pollen-robotics/dxl-fan-module/dxl-fan-module/schematic.pdf

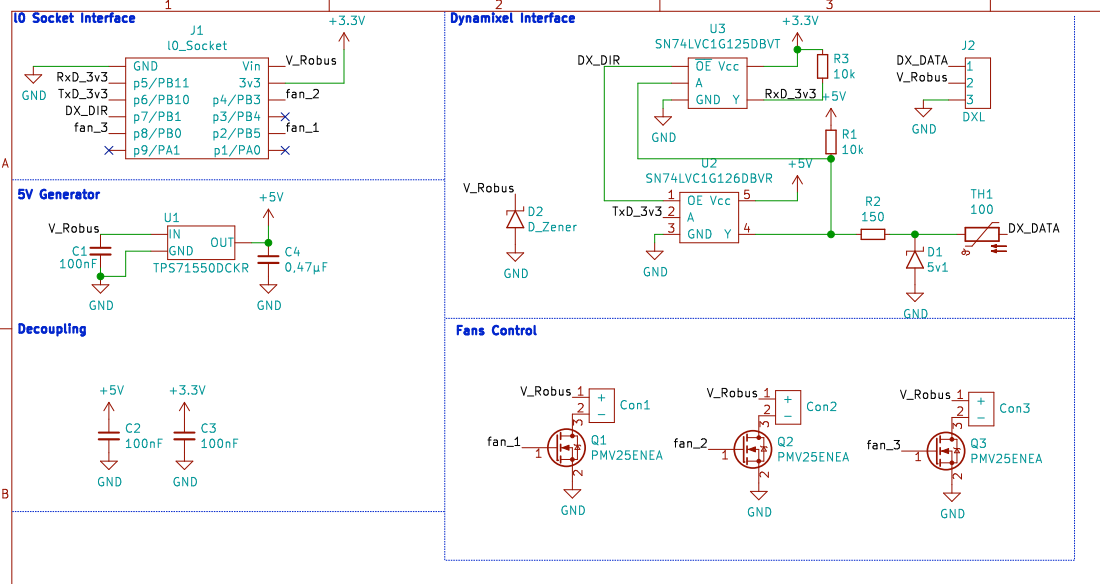
[picture p2: page 1]
