pollen-robotics/dxl-fan-module/(commit log)

2020-04-07 Add KiCad project
    [l0_Dynamixel.kicad_pcb, l0_Dynamixel.sch]
2020-04-07 Move files to a folder
    [l0_Dynamixel.kicad_pcb, l0_Dynamixel.sch]
2020-04-07 Add connectors for fans, logos and improve route tracks
    [l0_Dynamixel.kicad_pcb, l0_Dynamixel.sch]
2020-04-08 Change connectors
    [l0_Dynamixel.kicad_pcb, l0_Dynamixel.sch]
2020-04-08 Fix D_Zener and silkscreen/fab layers
    [l0_Dynamixel.kicad_pcb, l0_Dynamixel.sch]
2020-04-08 Change 1k resistors into 0ohm
    [l0_Dynamixel.kicad_pcb, l0_Dynamixel.sch]
2020-04-08 Change filled zones
    [l0_Dynamixel.kicad_pcb]
2020-04-08 Remove useless vias
    [l0_Dynamixel.kicad_pcb]
2020-04-08 Rename files
    [dxl-fan-module.kicad_pcb, dxl-fan-module.sch]
2020-04-09 Remove 0ohm resistors
    [dxl-fan-module.kicad_pcb, dxl-fan-module.sch]
2020-04-09 Change farnell code for R1 and R3
    [dxl-fan-module.sch]
2020-05-05 Add files needed for production
    [BOM_dxl-fan-module.csv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]
2022-12-16 Update references
    [dxl-fan-module.sch]
2023-02-14 Add prod files and schematic pdf
    [dxl-fan-module-B_Adhes.gbr, dxl-fan-module-B_CrtYd.gbr, dxl-fan-module-B_Cu.gbr, dxl-fan-module-B_Fab.gbr, dxl-fan-module-B_Mask.gbr, dxl-fan-module-B_Paste.gbr, dxl-fan-module-Edge_Cuts.gbr, dxl-fan-module-F_Adhes.gbr]
